Matp101/RoboticArm/Diagrams/Pictures/Exterior2.jpg

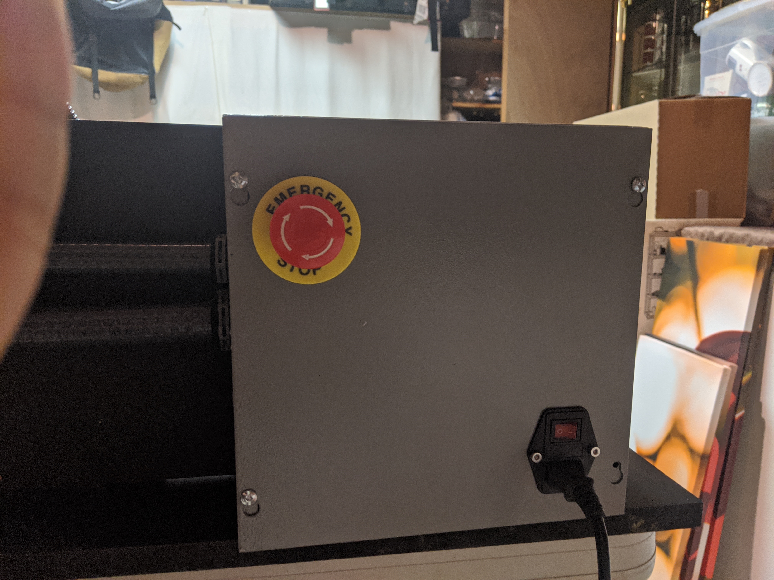
Diagrams/Pictures/Exterior2.jpg
