Matp101/RoboticArm/README.md

# Robotic Arm

This robotic are was created for St Clair College Electronic Engineering Technology Capstone Project.

This robotic arm is a functional robot built using a Arduino Mega
