Matp101/RoboticArm/Diagrams/Block/Block Diagram.png

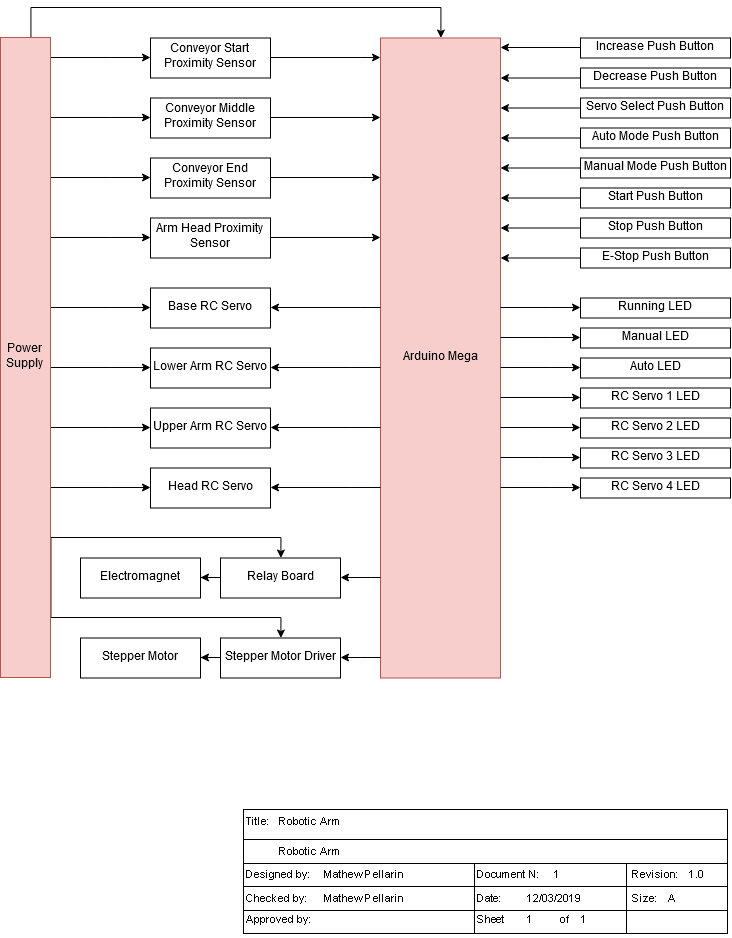
Diagrams/Block/Block Diagram.png
