Matp101/RoboticArm/Diagrams/Mechanical/ARM.png

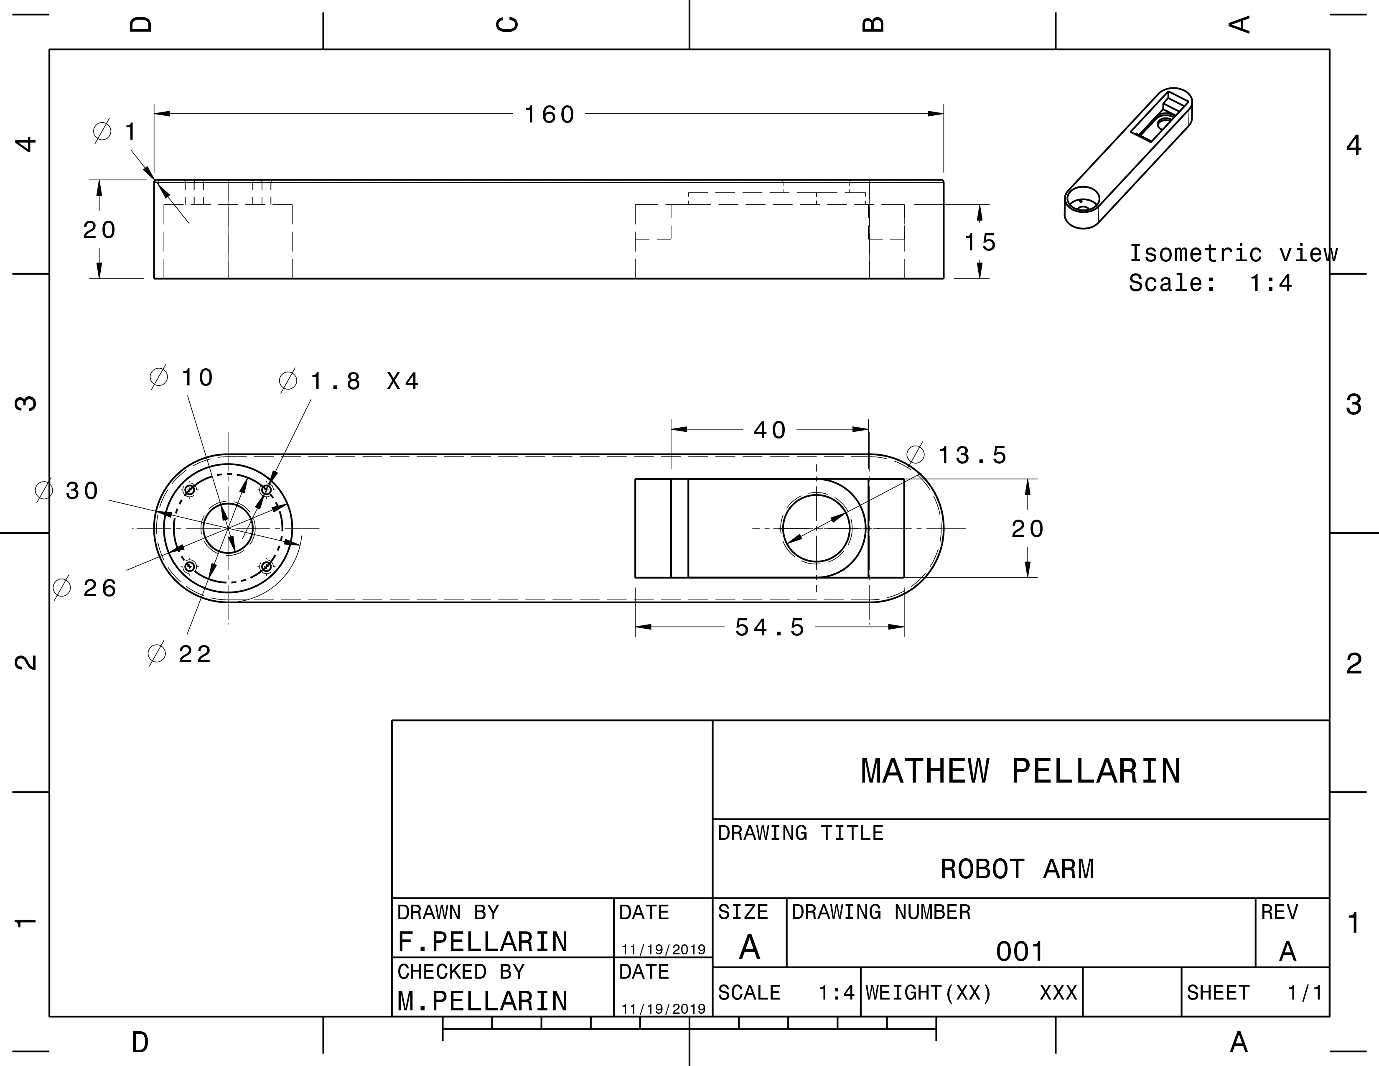
Diagrams/Mechanical/ARM.png
