Matp101/RoboticArm/Diagrams/Mechanical/ASSY.png

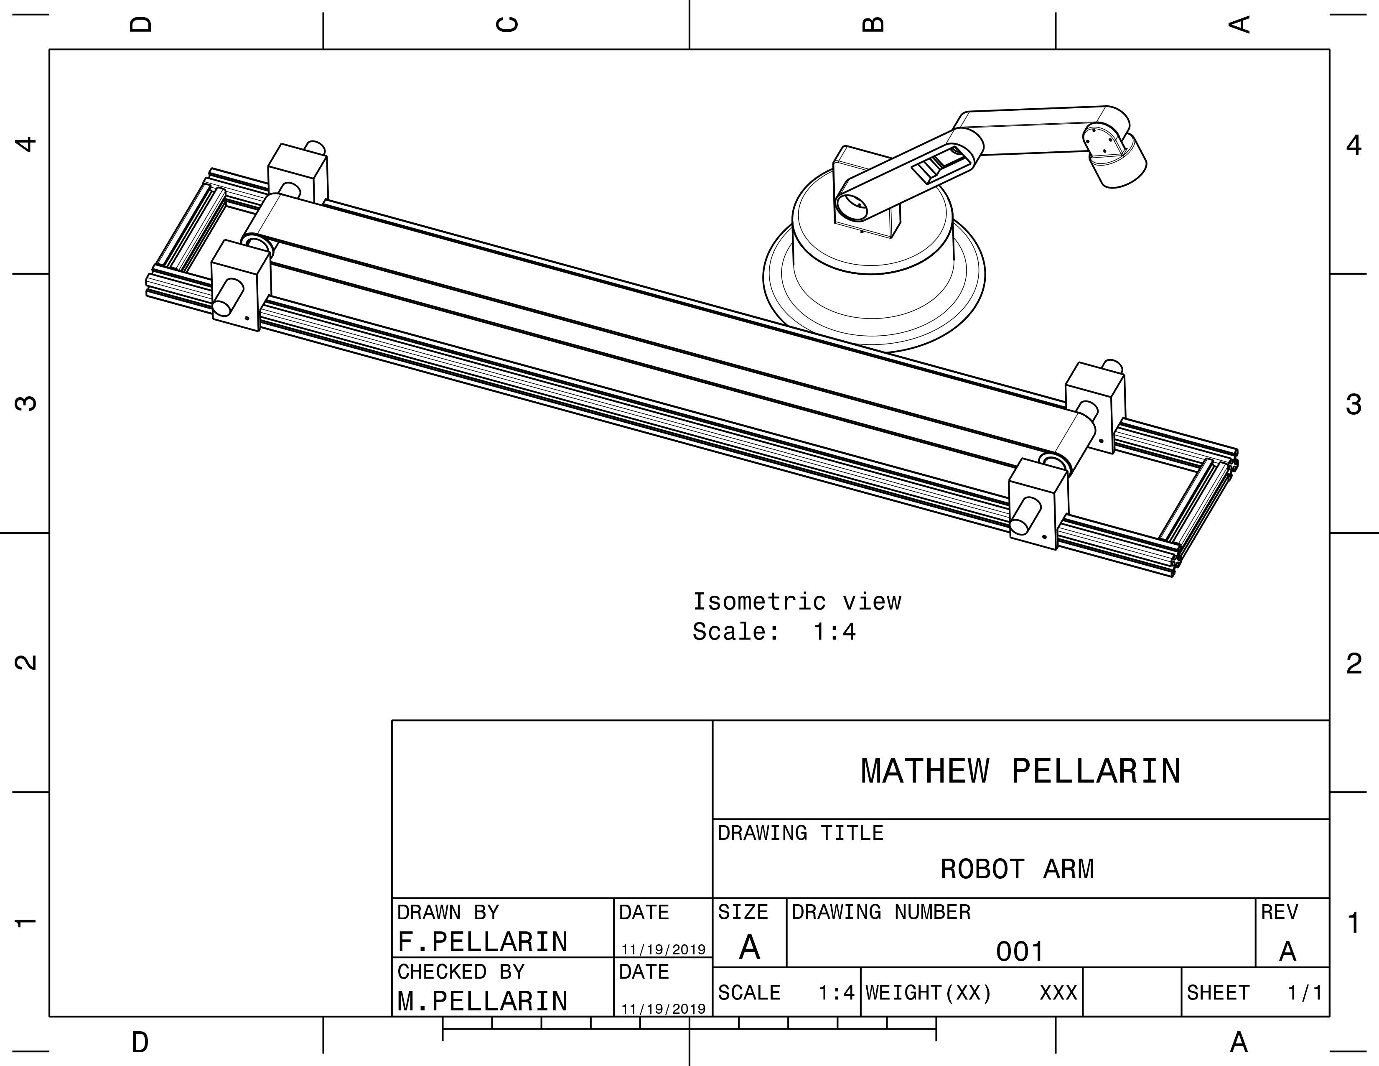
Diagrams/Mechanical/ASSY.png
