Matp101/RoboticArm/Diagrams/Mechanical/BOTTOM.png

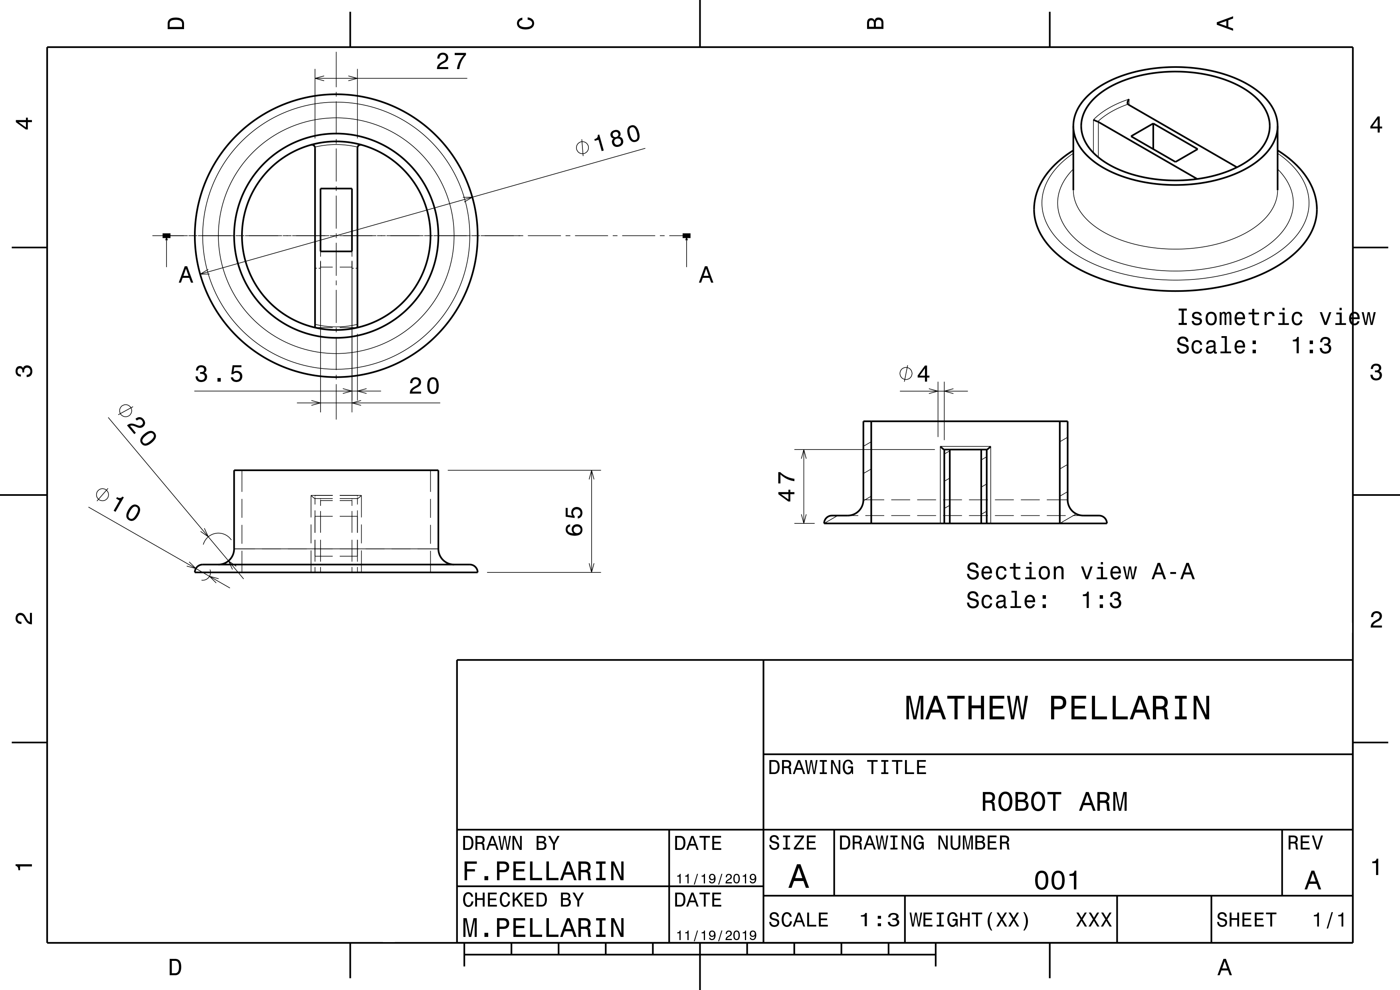
Diagrams/Mechanical/BOTTOM.png
