Matp101/RoboticArm/Diagrams/Mechanical/CONVAYOR.png

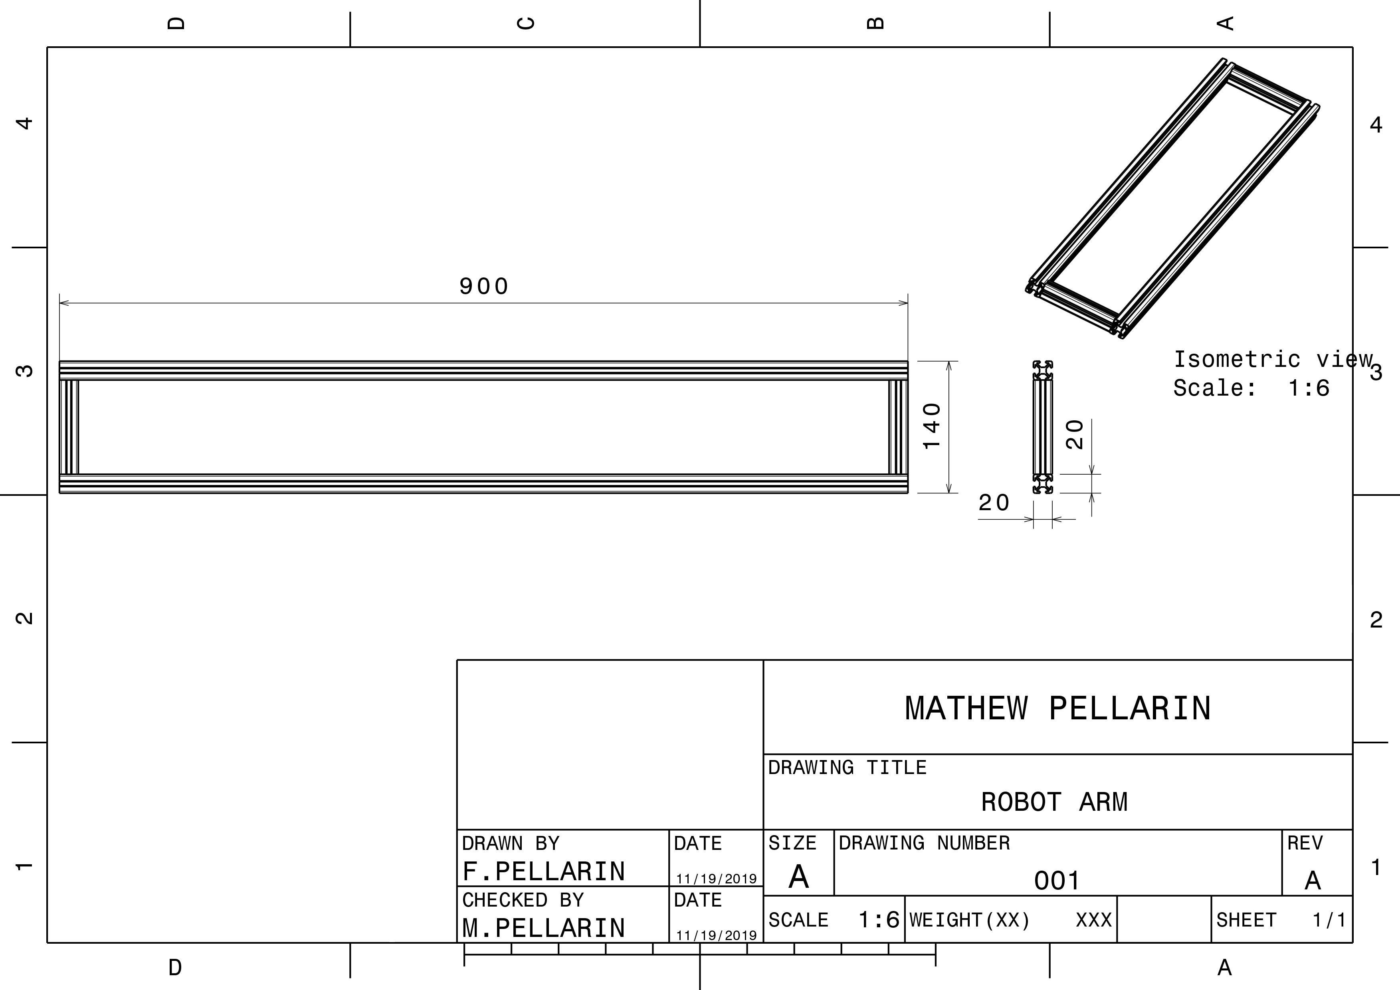
Diagrams/Mechanical/CONVAYOR.png
