Matp101/RoboticArm/Diagrams/Mechanical/HOLDER.png

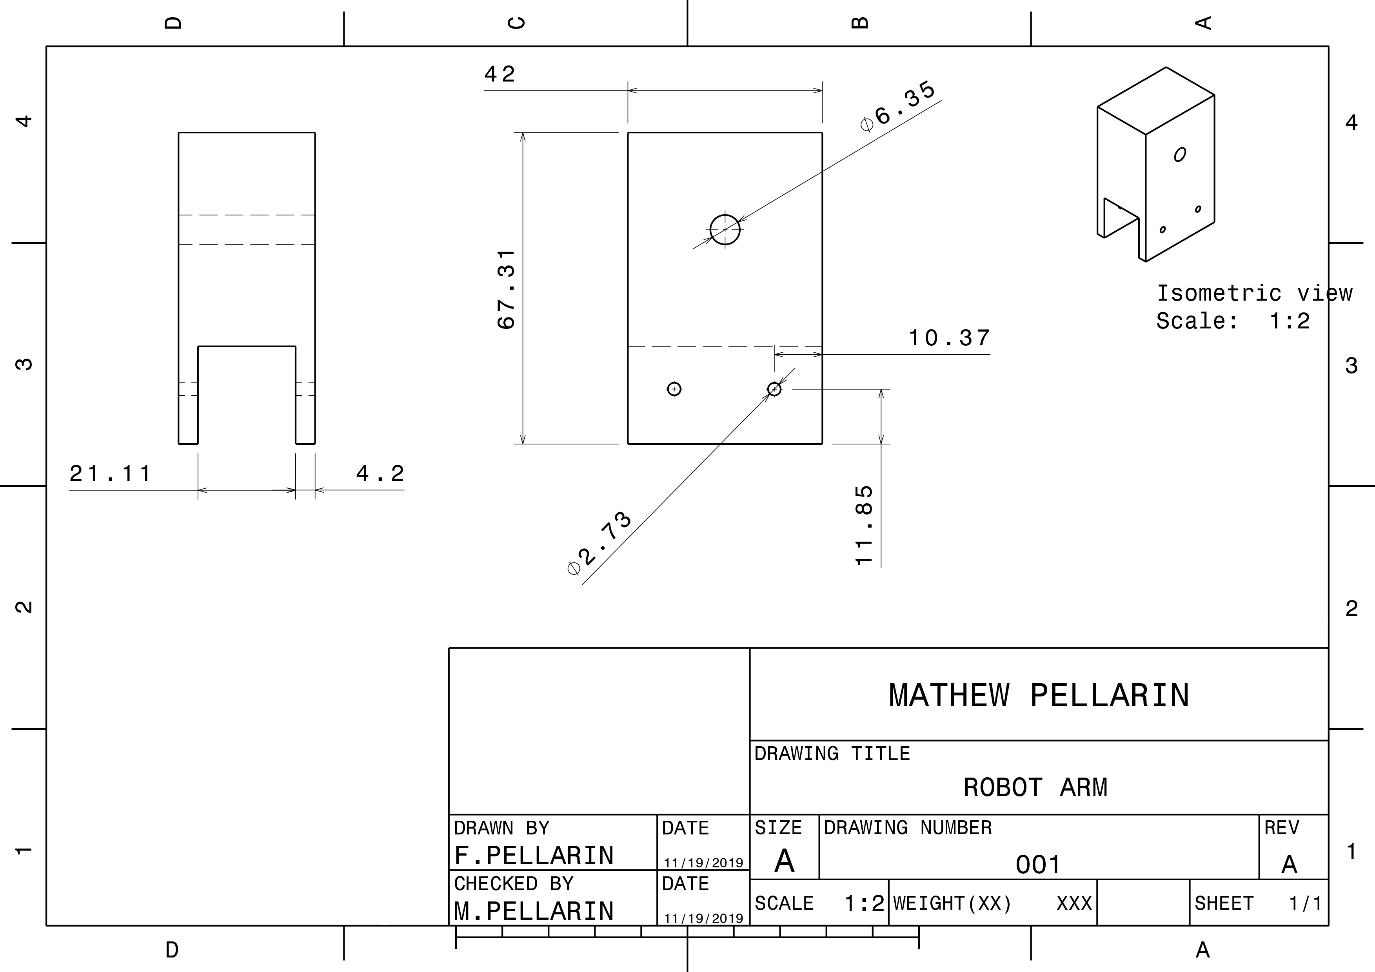
Diagrams/Mechanical/HOLDER.png
