Matp101/RoboticArm/Diagrams/Mechanical/MAGNET HOLD.png

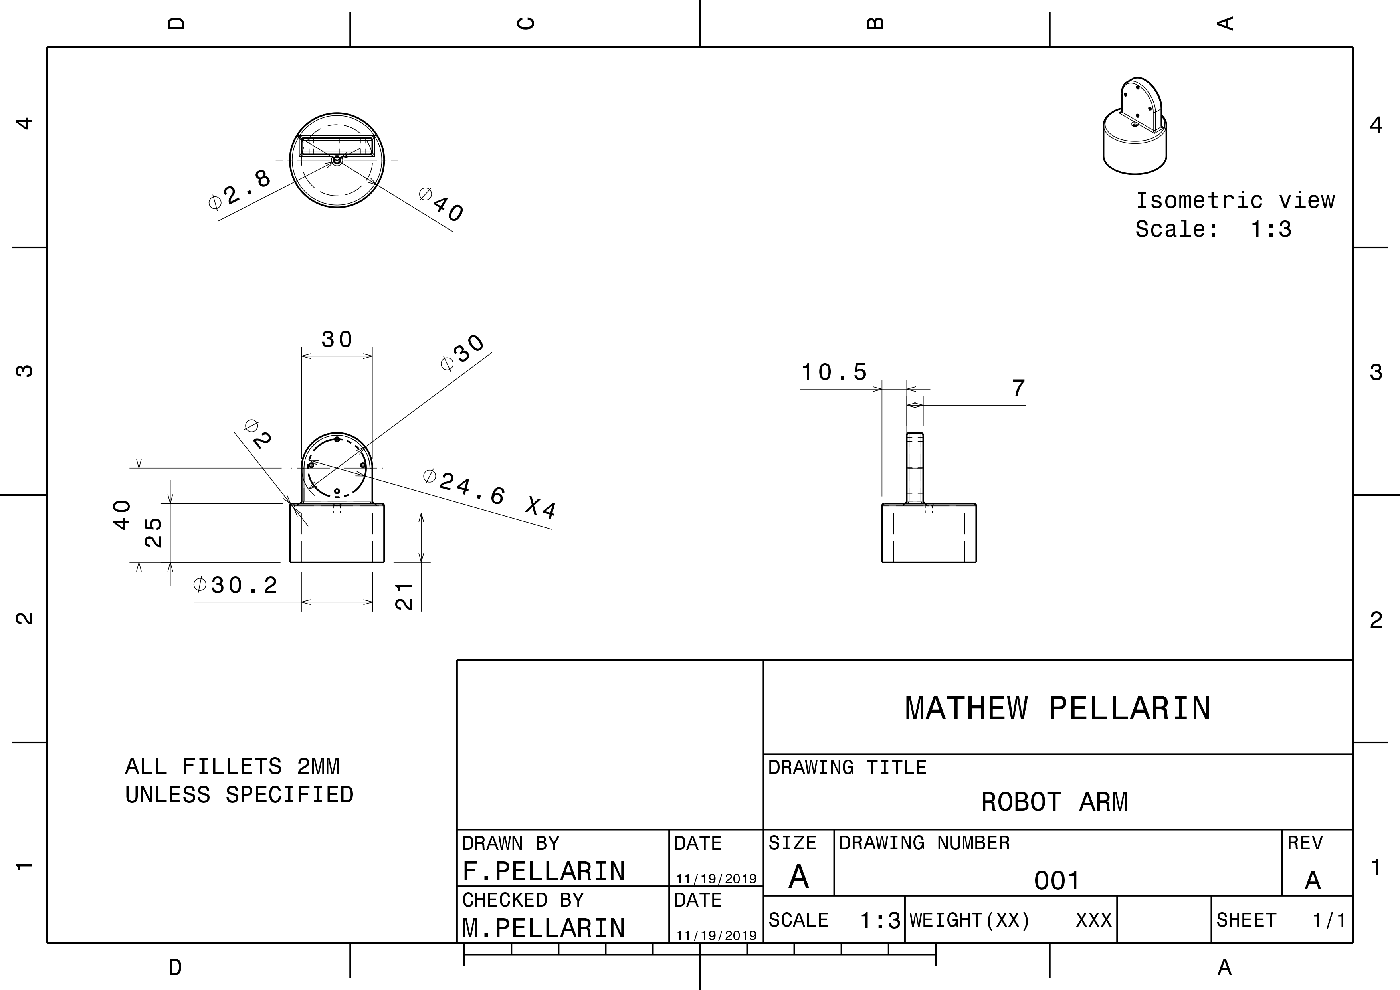
Diagrams/Mechanical/MAGNET HOLD.png
