Matp101/RoboticArm/Diagrams/Mechanical/PIPE.png

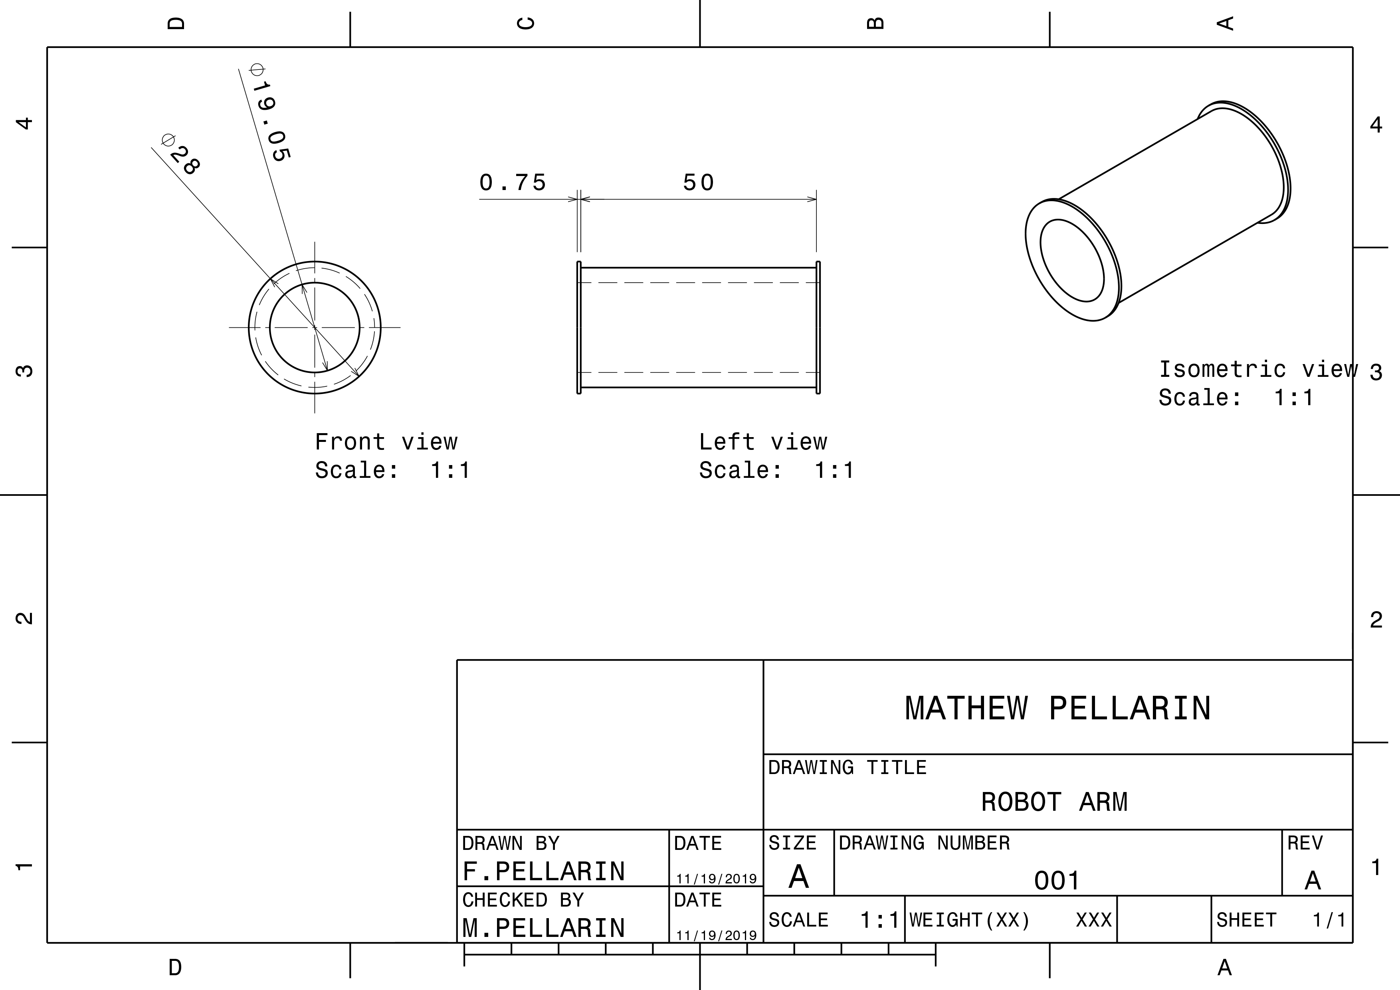
Diagrams/Mechanical/PIPE.png
