Matp101/RoboticArm/Diagrams/Mechanical/TOP.png

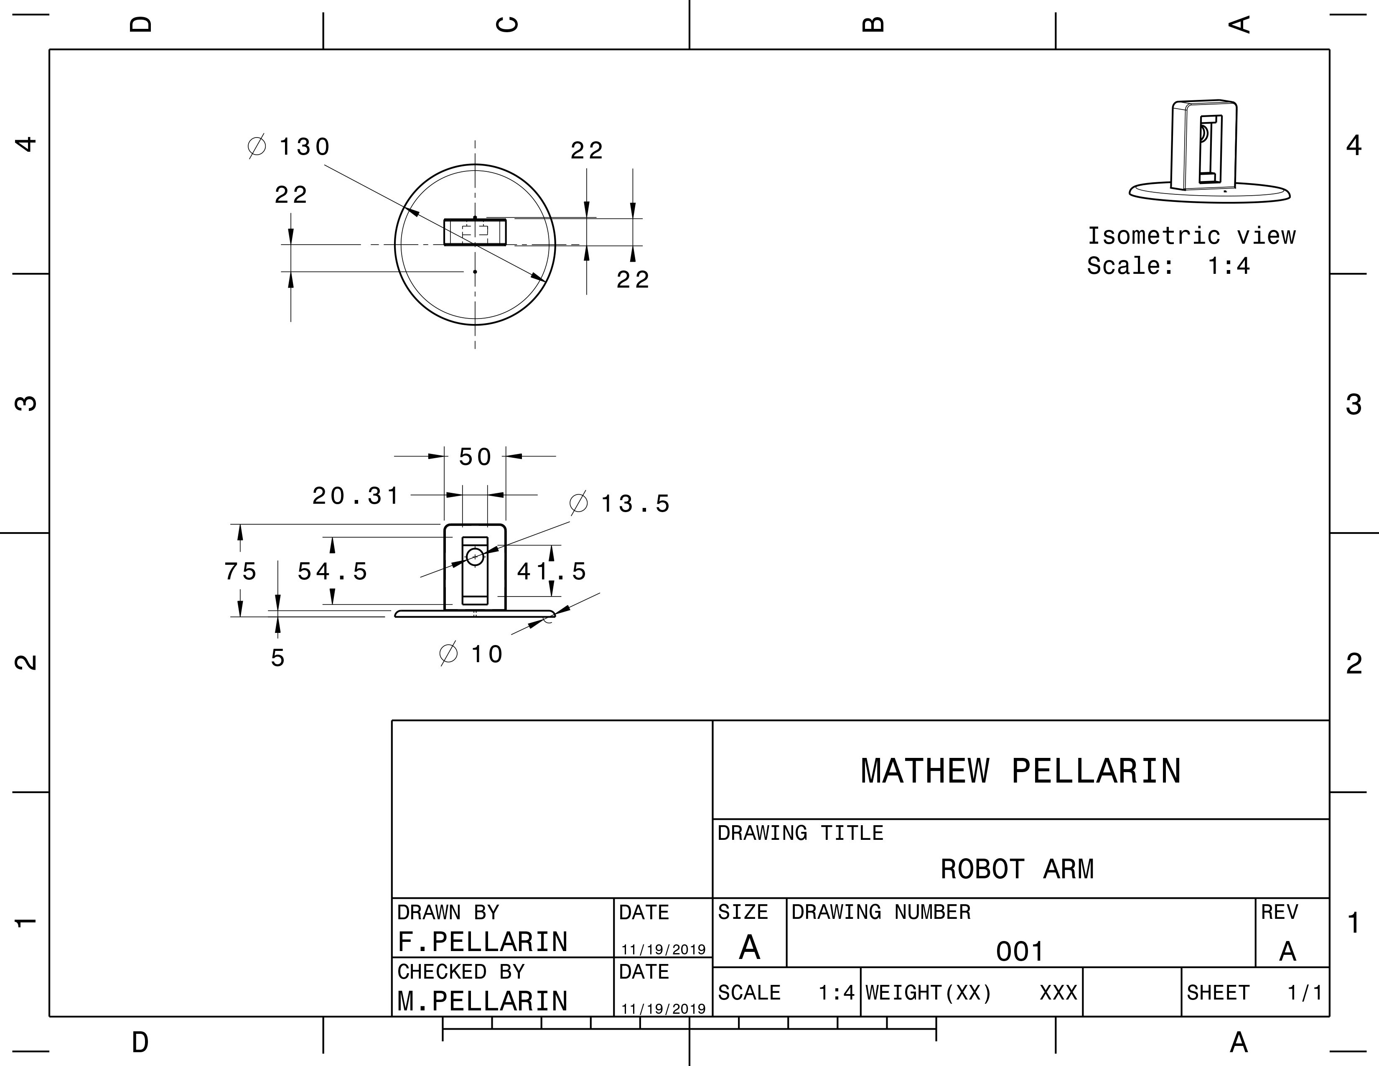
Diagrams/Mechanical/TOP.png
