Matp101/RoboticArm/STLs/Arm/Arm_Lower_Base.stl

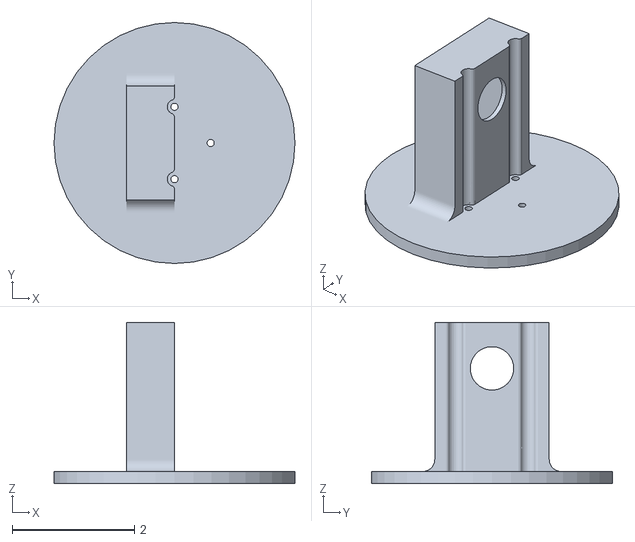
[picture p55: CAD file, 2021-10-07]
STLs/Arm/Arm_Lower_Base.stl
3.94 x 3.94 x 2.63
