Matp101/RoboticArm/STLs/Converyor/Conv_Roller_Holder.stl

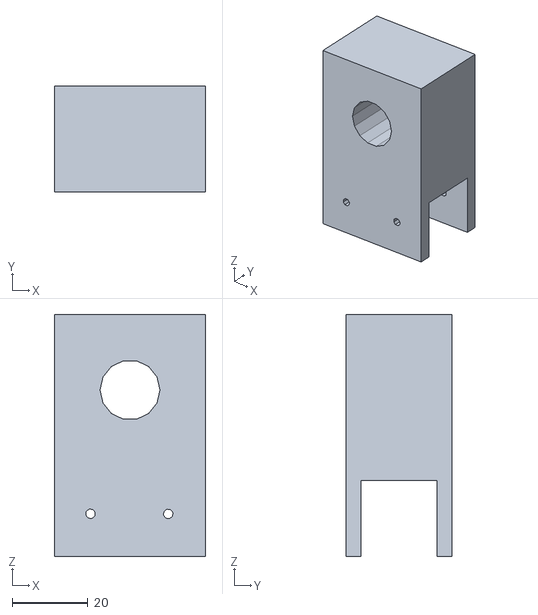
[picture p56: CAD file, 2021-10-07]
STLs/Converyor/Conv_Roller_Holder.stl
40.0 x 28.1 x 64.1
