Matp101/RoboticArm/STLs/Arm/Arm_Arm.stl

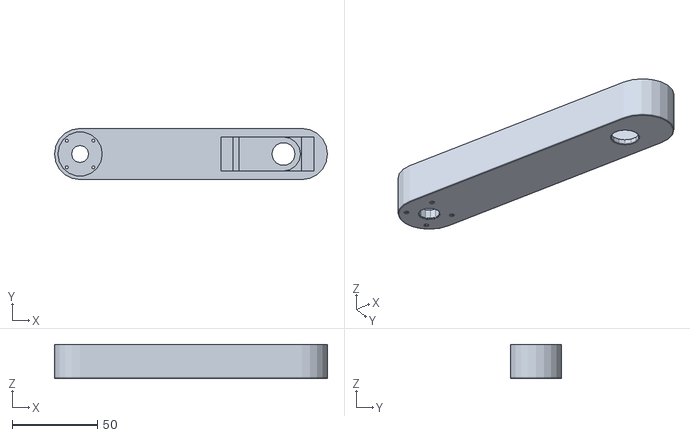
[picture p57: CAD file, 2021-10-07]
STLs/Arm/Arm_Arm.stl
160.0 x 30.0 x 20.0
