Matp101/RoboticArm/STLs/Converyor/Conv_Roller.stl

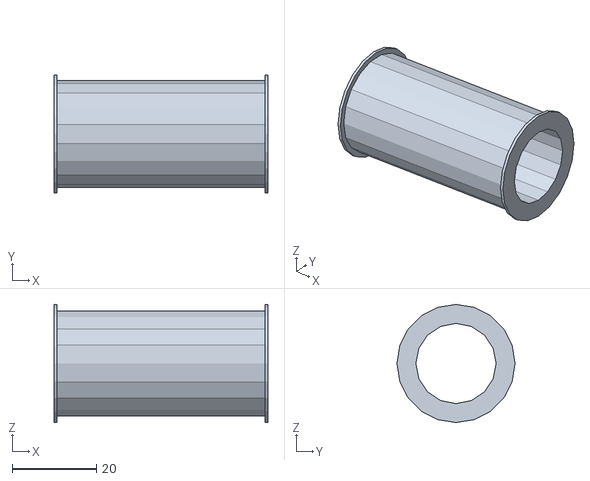
[picture p58: CAD file, 2021-10-07]
STLs/Converyor/Conv_Roller.stl
50.8 x 28.0 x 28.0
