Matp101/RoboticArm/STLs/Arm/Arm_Upper_Base.stl

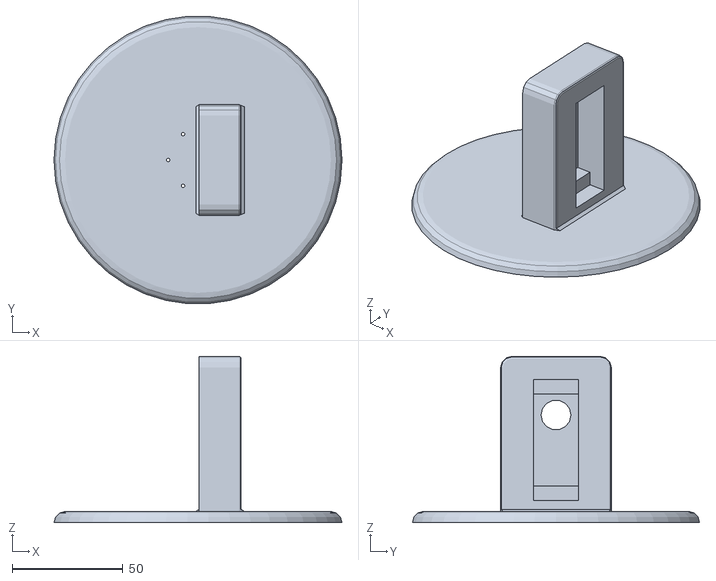
[picture p59: CAD file, 2021-10-07]
STLs/Arm/Arm_Upper_Base.stl
130.0 x 129.6 x 75.0
