Matp101/RoboticArm/STLs/Converyor/Conv_Prox_Holder.stl

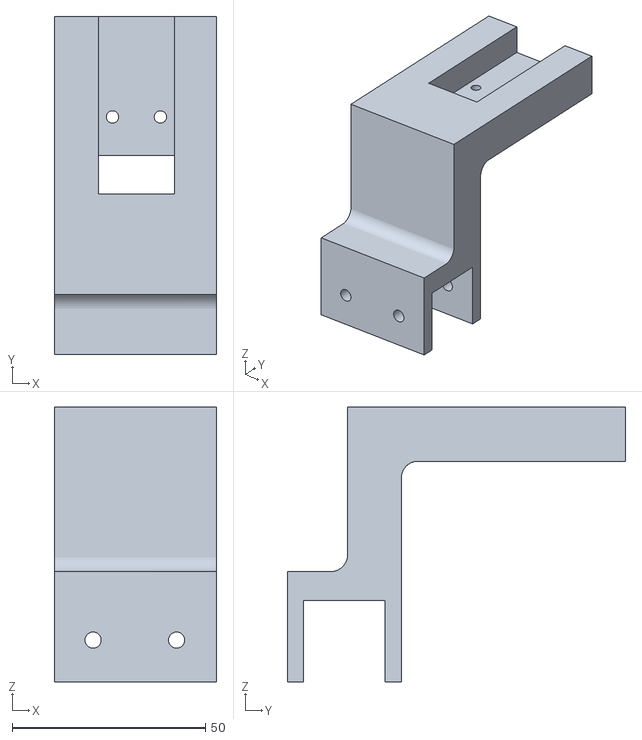
[picture p60: CAD file, 2021-10-07]
STLs/Converyor/Conv_Prox_Holder.stl
42.0 x 87.5 x 71.1
