Matp101/RoboticArm/STLs/Arm/Arm_Magnet_Holder.stl

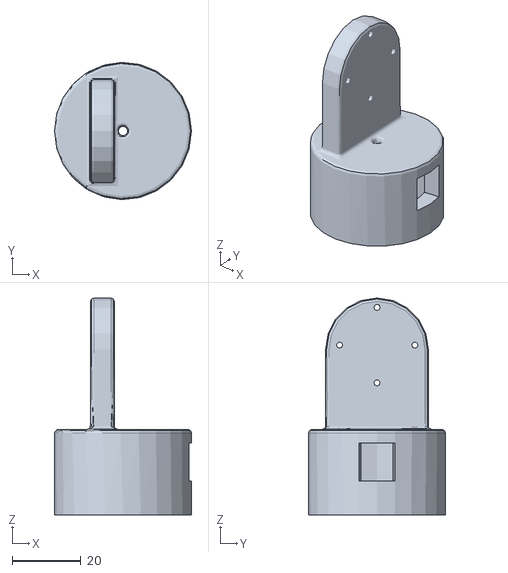
[picture p61: CAD file, 2021-10-07]
STLs/Arm/Arm_Magnet_Holder.stl
40.0 x 40.0 x 63.3
