Matp101/RoboticArm/Diagrams/Pictures/Arm1.jpg

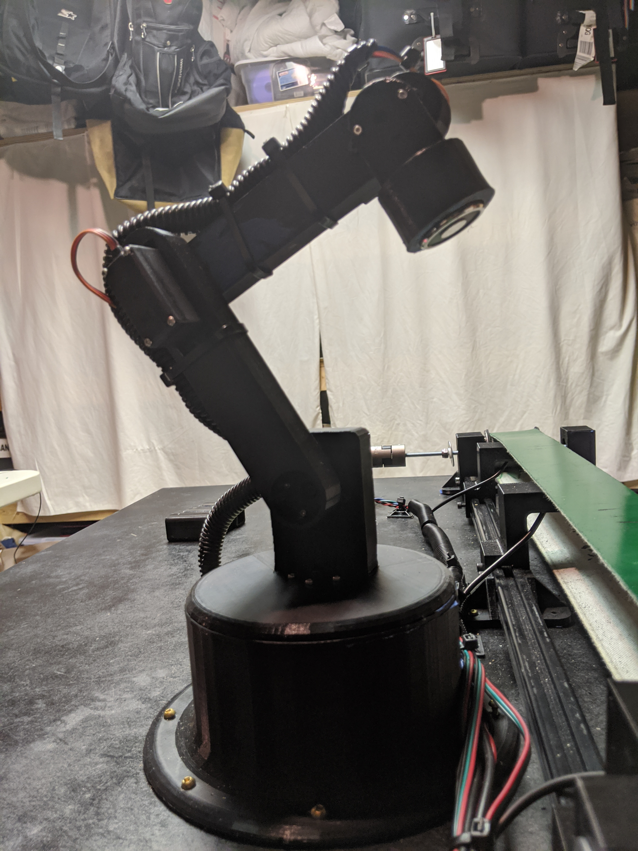
Diagrams/Pictures/Arm1.jpg
